F6ITU/RP16_Frontend/README.md

# RP16_Frontend
dual RX/TX SDR frontend for the 16 bits Red Pitaya dev board
