F6ITU/RP16_Frontend/doc/red pitaya frontend rx.png

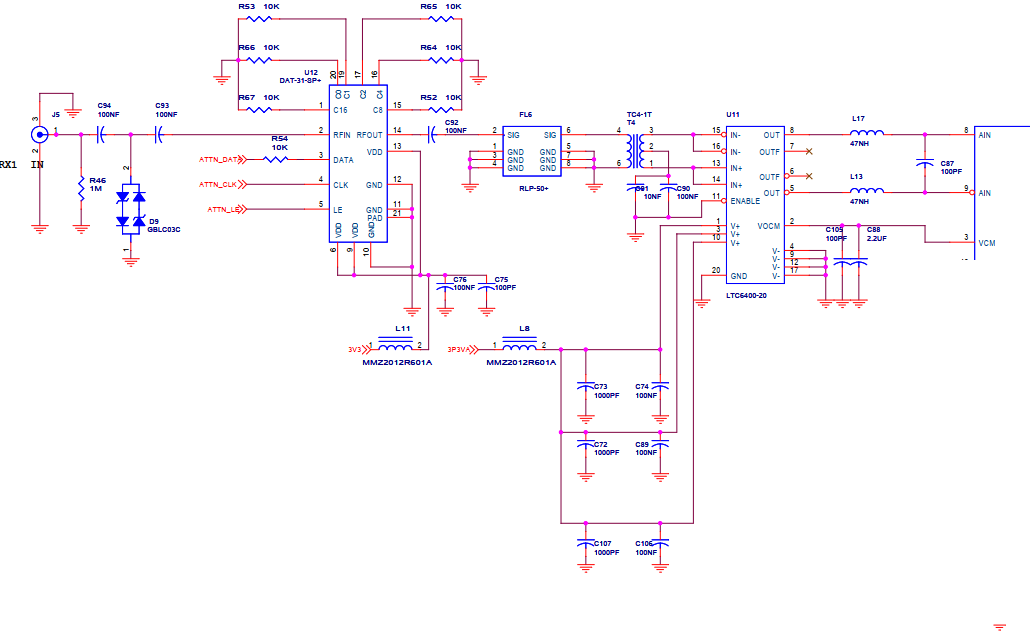
doc/red pitaya frontend rx.png
