F6ITU/RP16_Frontend/RX Schematic.PNG

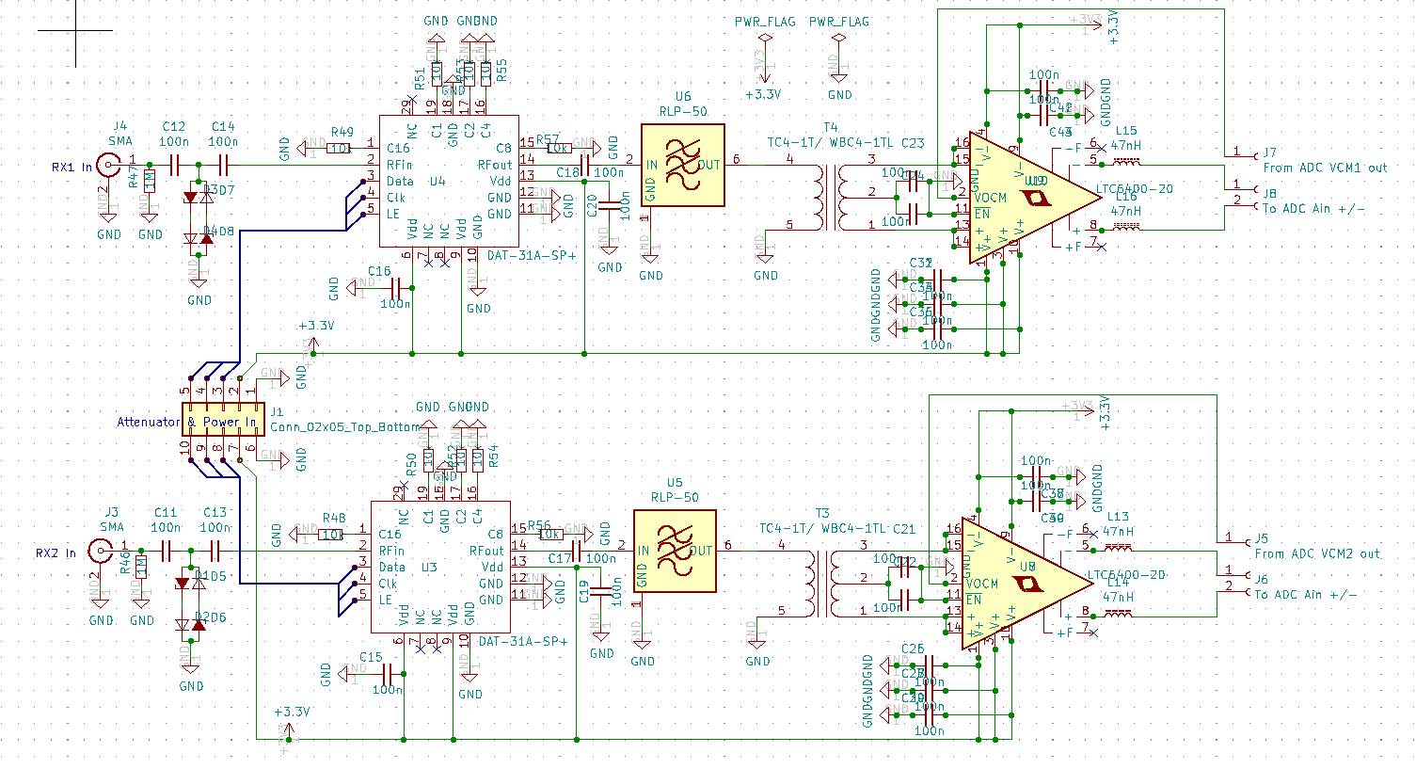
RX Schematic.PNG
