F6ITU/RP16_Frontend/TX Schematic.PNG

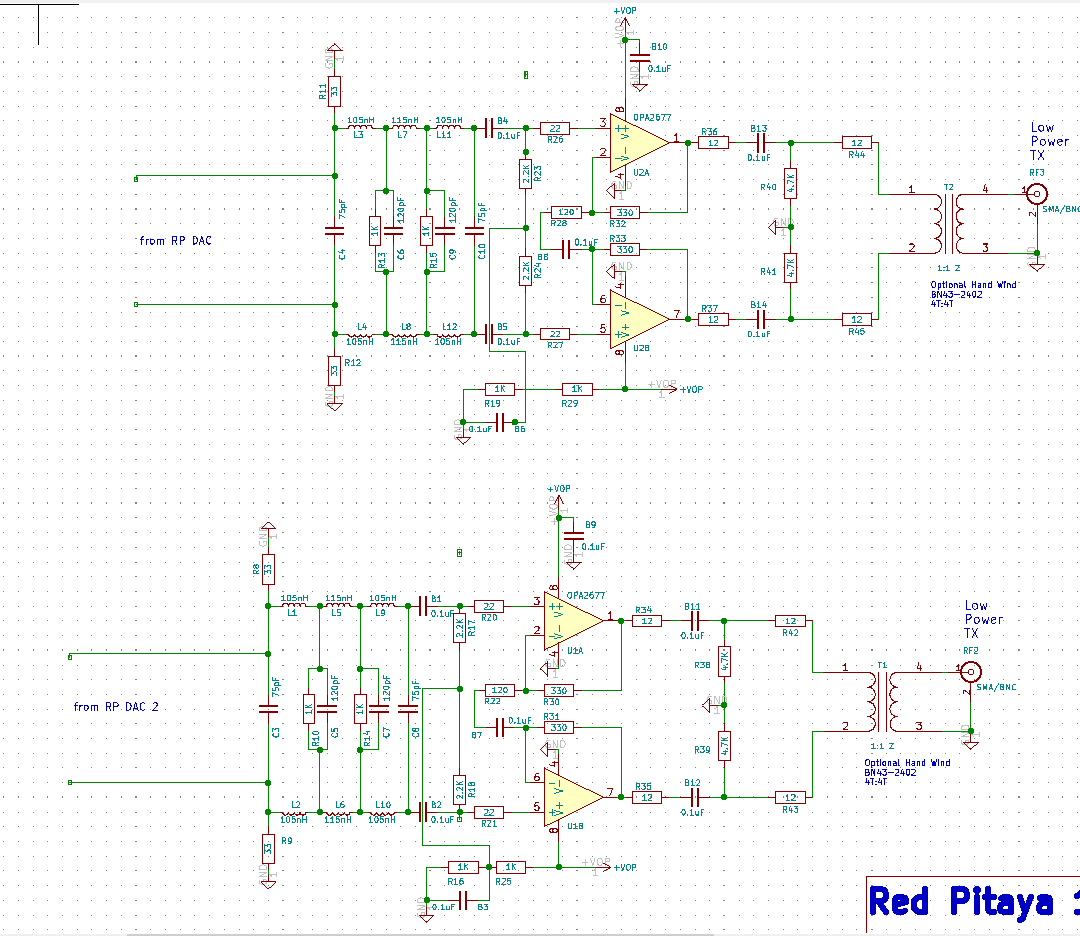
TX Schematic.PNG
