F6ITU/RP16_Frontend/(commit log)

2020-05-07 first schematic
    [RX.sch, TX.sch, rp16.kicad_pcb, rp16.sch]
2020-05-07 schematic png added
    [RX.sch, TX.sch]
